carlosmilek/Apple2DiskESP32/BOM.csv

Id | Designador | Footprint | Quantidade | Designação | Fornecedor e referência
1 | C1, C2, C3 | CAP-TH_L5.8-W2.4-P2.54-D0.6 | 3
2 | D1 | DO-41_BD2.4-L4.7-P8.70-D0.8-RD | 1
3 | ESP1 | ESP32-S3-DevKitC | 1
4 | J1 | IDC-TH_20P-P2.54-V-R2-C10-S2.54 | 1
5 | R1, R2, R3, R4 | RES-TH_BD2.3-L6.5-P10.50-D0.5 | 4
6 | U1, U2 | DIP-16_L20.3-W10.2-P2.54-LS10.2-BL | 2
7 | U3 | DIP-14_L19.2-W6.6-P2.54-LS10.9-BL | 1
