carlosmilek/Apple2DiskESP32/SCH_Schematic2_2026-07-12.pdf

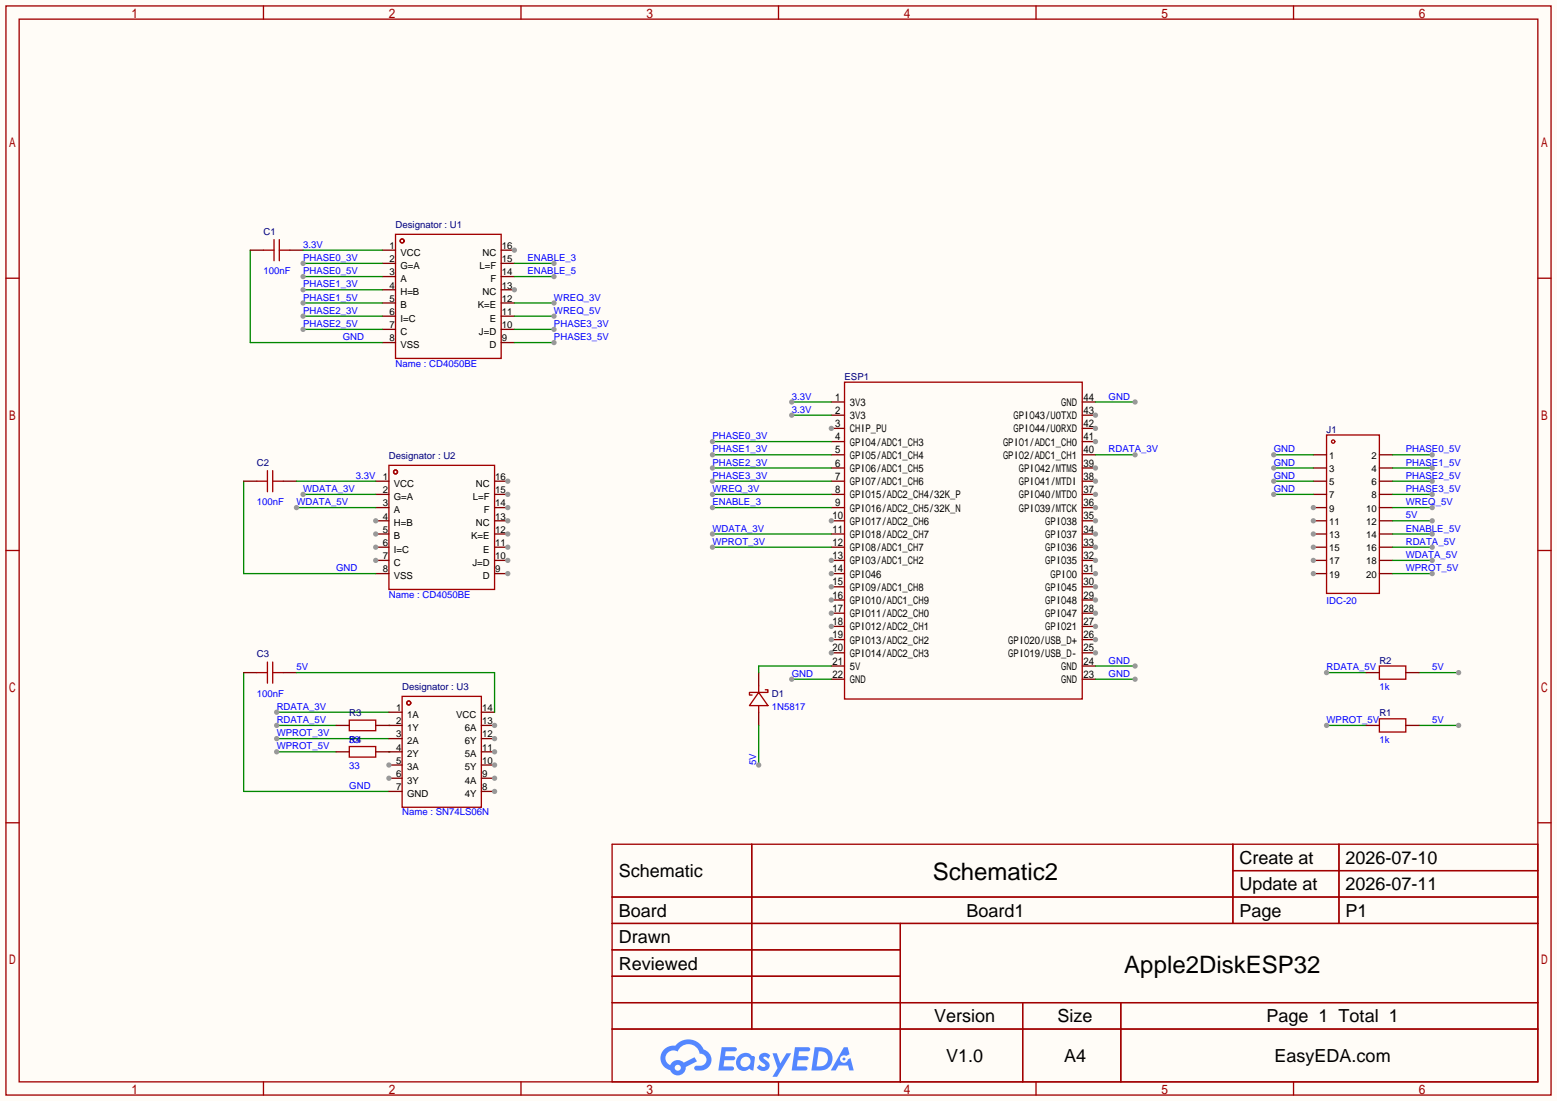
[picture p1: page 1]

Schematic | Schematic2 | Create at | 2026-07-10

Update at | 2026-07-11

Board | Board1 | Page | P1
Drawn | | Apple2DiskESP32
Reviewed

Version | Size | Page 1 Total 1
V1.0 | A4 | EasyEDA.com
