carlosmilek/Apple2DiskESP32/(commit log)

2026-07-10 Add Apple II Disk Controller for ESP32-S3
    V1
2026-07-11 Update README with hardware specifications
    Added hardware specifications for ESP32-S3-DevKitC-1.
2026-07-11 Update README to note read-only status
    Added a note indicating that the project is currently read-only and that write functionality will be implemented soon.
2026-10-03 Add files via upload
    Untested PCB layout
    [BOM.csv]
